kjlisby/train_elevator/Diagram.pptx

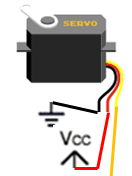
[picture p4: figure]
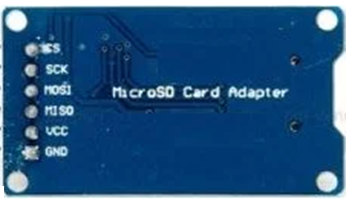
[picture p5: figure]

## Slide 2

+3,3V

+5V

## Slide 3

+3,3V

IR sensors

+5V

## Slide 4

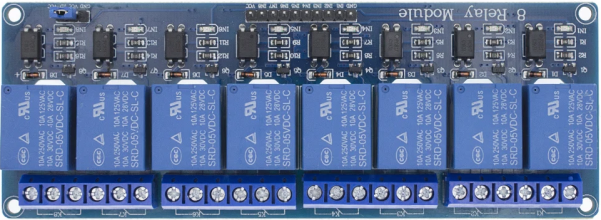
[picture p6: figure]

+5V

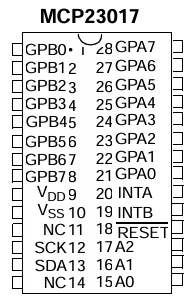
[picture p7: figure]

+3,3V

+3,3V

+3,3V

4K7

end-stop

IR sensors

IR LEDs

## Slide 5

+5V

+3,3V

+3,3V

+3,3V

4K7

IR sensors

end-stop

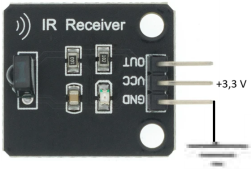
[picture p8: figure]
