kjlisby/train_elevator/GPIO Assignment.jpg

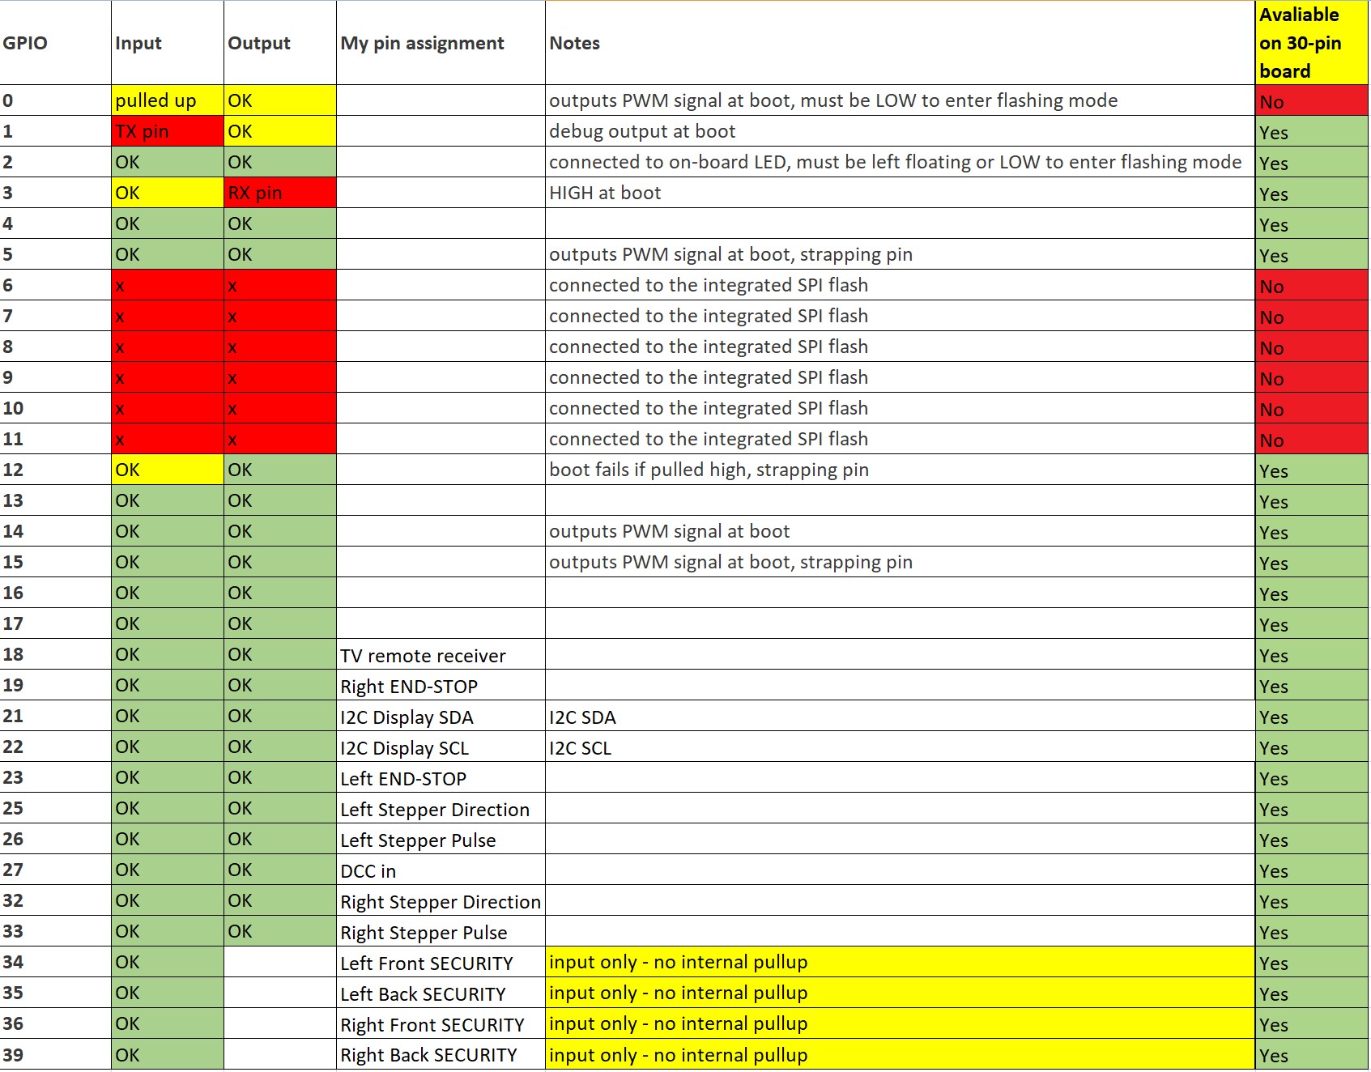
GPIO Assignment.jpg
