kjlisby/train_elevator/serial_elevator/IRsensor.h

#ifndef IRSENSOR_H
#define IRSENSOR_H

#include <Arduino.h>

class IRsensor {
  public:
    void   Init (uint8_t Pin);
    bool   TrainSeen ();
    void   Loop();
  private:
    unsigned long trainDetectionMillis = 0;
    unsigned long loopCounter = 0;
    uint8_t IR_pin;
};

#endif
