kjlisby/train_elevator/serial_elevator/PosLogic.h

#ifndef POS_LOGIC_H
#define POS_LOGIC_H

#include <AccelStepper.h>
#include "Calibrator.h"
#include "Display.h"
#include "Relays.h"
#include "IRsensor.h"

#define LH_STEPPER_DIR_PIN 25
#define LH_STEPPER_STEP_PIN 26
#define RH_STEPPER_DIR_PIN 32
#define RH_STEPPER_STEP_PIN 33
#define LH_ENDSTOP_PIN 23
#define RH_ENDSTOP_PIN 19

#define STATUS_IDLE     0
#define STATUS_HOMING_1 1
#define STATUS_HOMING_2 2
#define STATUS_HOMING_3 3
#define STATUS_HOMING_4 4
#define STATUS_MOVING   5

class PosLogic {
  public:
    void   Init (Calibrator *CA, Display *DI, Relays *RE, IRsensor *RLIR, IRsensor *FLIR, IRsensor *FRIR, IRsensor *RRIR);
    void   Reset ();
    void   Lock ();
    void   Unlock ();
    bool   MoveTo (int Level, int AdditionalSteps);
    bool   MoveToSteps (int Level, int StepsLeft, int StepsRight);
    bool   MoveOneStepper (bool RIGHT, bool RELATIVE, int Steps);
    String GetStatus ();
    int    GetCurrentLevel ();
    String GetStepperPositions ();
    bool   isRunning();
    bool   isBlocked();
    bool   isLocked();
    void   Loop ();

  private:
    AccelStepper *LHStepper;
    AccelStepper *RHStepper;
    Calibrator   *MyCalibrator;
    Display      *MyDisplay;
    Relays       *MyRelays;
    IRsensor     *FrontLeft_IR;
    IRsensor     *RearLeft_IR;
    IRsensor     *FrontRight_IR;
    IRsensor     *RearRight_IR;
    int          MyStatus = STATUS_IDLE;
    int          CurrentLevel = 0;
    int          NextLevel    = 0;
    bool         Locked       = false;
    bool         Blocked      = false;
    bool         HomingDone   = false;
};

#endif
