kjlisby/train_elevator/wifi_elevator/JSONArray.h

#ifndef JSONARRAY_H
#define JSONARRAY_H

#include <WString.h>

extern String JSON_ArrayStart();
extern String JSON_ArrayDivider();
extern String JSON_ArrayEnd();
extern String JSON_item(String Name, String Value);

#endif
