kjlisby/train_elevator/wifi_elevator/SDWebServer.h

#ifndef SD_WEB_SERVER_H
#define SD_WEB_SERVER_H

#include <stdint.h>
#include <WiFi.h>
#include <WebServer.h>
#include <SD.h>

class SDWebServer {
  public:
    void Init(uint8_t SDPin);
    WebServer *getServer();
    bool loadFromSdCard (String path);
    void sendMessage (String message);
    void Loop();
  private:
    uint8_t sd_pin;
    
    #include "MySecretPassword.h"
    // You must have a file named MySecretPassword.h
    // and that file must contain the SSID and the password
    // for your WIFI and for your ESP32 in AP mode. Syntax as follows:
    // const char* ssid = "xxxxxx";
    // const char* password = "yyyyyyy";
    // const char* APssid = "zzzzzz";
    // const char* APpassword = "vvvvvvv";

    WebServer *server;
    IPAddress *apIP;
    IPAddress *staticIP;
    IPAddress *gateway;
    IPAddress *subnet;
    void returnOK();
    void returnFail (String msg);
    void setupNetwork(bool AP);
};

#endif
