kjlisby/train_elevator/(commit log)

2023-09-30 Update Calibrator.h
    Adapted to 12 levels and to always approaching from below.
2023-09-30 Calibrator added.
2023-10-03 No need to use println - just print
2023-10-04 Code files moved to elevator subdirectory to please the Arduino IDE PosLogic files added
2023-10-05 Security sensors put into use. End-stop sensors changed to inverted polarity.
    [PosLogic.cpp, PosLogic.h]
2023-10-05 Status must not show Locked
    The lock/unlock mechanism is used by JMRI in a way where GetStatus is polled until it reflects the elevator is steady at the requested level. And that mechanism will not work if GetStatus reports LOCKED.
    [PosLogic.cpp]
2023-10-06 Button styling added
2023-10-06 12 buttons added. Garden train stuff commented out.
2023-10-08 Arduino IDE insists that a CPP file must exist for every h file.
2023-10-11 Cleanup
    onNotFound held internally
    The full loop functionality held internally
    IP address changed to not overlap arduino_train
    Debug info added when WIFI is not connecting
2023-10-12 Debugging println added to GetCalibration
2023-10-12 Cleanup in println statements
2023-10-12 MaxSpeed and Acceleration corrected. isRunning() added
    [PosLogic.cpp]
2023-10-12 Don't do anything else while steppers are running
2023-10-17 WIP - buttons etc. added
2023-10-19 Saving and restoring calibration data debugged.
2023-10-19 Homing implemented as an implicit thing of first MoveTo. Lock/Unlock mechanism made available on the serial interface.
2023-10-20 Queue mechanism to make communication between threads possible
2023-10-20 Added extra security in case the elevator is blocked
2023-10-21 Added a better CAD drawing
2023-10-21 Adding new CAD drawing again
2024-09-16 Added control of relays for powering train tracks.
2024-09-16 Diagram updated with relays etc.
2024-09-16 Reset bias added to diagram. Port numbers corrected in SW.
    [Relays.cpp]
2024-09-17 Arduino relay modules are active low. Hence logic has been reversed.
    [Relays.cpp]
2024-09-24 GPIO assignment changed to avoid external pull-up resistors.
    [GPIO Assignment.xlsx]
2024-09-24 jpg file updated from powerpoint file
2024-09-25 1K resistor at output of DCC decoder re-introduced. DCCInterface class changed to react to adresses only and not state.
2024-09-28 IRsensor added.
    [GPIO Assignment.xlsx]
2024-09-28 Indentation unified to two spaces. Just because that is what Arduino IDE seems to prefer.
2024-10-04 TV remote added.
    [GPIO Assignment.xlsx]
2024-10-10 More IR sensor debugging
2024-10-10 Bug in previous commit corrected.
    [serial_elevator.ino]
2024-10-10 Print information about any TV remote button press on serial console.
2024-10-10 IRsensor made more robust against short spikes.
    [IRsensor.cpp, IRsensor.h, serial_elevator.ino]
2024-10-19 Homing debugged Tested for the first time with physical elevator leading to changes in speed, acceleration and default calibration
2024-10-19 Stepper speed increased
2024-10-28 IR sensors (and serial console) enabled while steppers are moving
2024-11-04 Timing for pushing button 1 changed. Timing for up/down changed. Keys on TVremote thrown away while steppers are moving.
2024-11-26 Instant feedback via display when TV remote button 1 is pressed, making it much easier to select level 1 and not 11.
2025-02-02 Behaviour of an IR sensor detecting a blockage changed, so that initiating a move will no longer be refused, whereas no stepper will move while such blockage is detected.
    [Display.cpp, Display.h, PosLogic.cpp, PosLogic.h, serial_elevator.ino]
